miguel-antoons/feb_timing_gates/documentation/INDEX.md

# FEB Timing Gates Documentation Index

Welcome to the FEB Timing Gates documentation. This system provides precise timing for racing events using ESP32-based wireless timing gates.

## Getting Started
- [Project Overview](PROJECT_OVERVIEW.md) - System architecture and components
- [Hardware Setup](HARDWARE_SETUP.md) - Physical setup of timing gates
- [Software Setup](SOFTWARE_SETUP.md) - Installation and configuration

## Usage
- [Usage Guide](USAGE_GUIDE.md) - How to operate the system
- [Communication Protocol](COMMUNICATION_PROTOCOL.md) - Technical details about device communication
- [Device Management](DEVICE_MANAGEMENT.md) - Managing senders and receivers

## Reference
- [Troubleshooting](TROUBLESHOOTING.md) - Common issues and solutions

## Additional Resources
- [README](../../README.md) - Project overview and quick start guide
