miguel-antoons/feb_timing_gates/documentation/project_schema.pdf

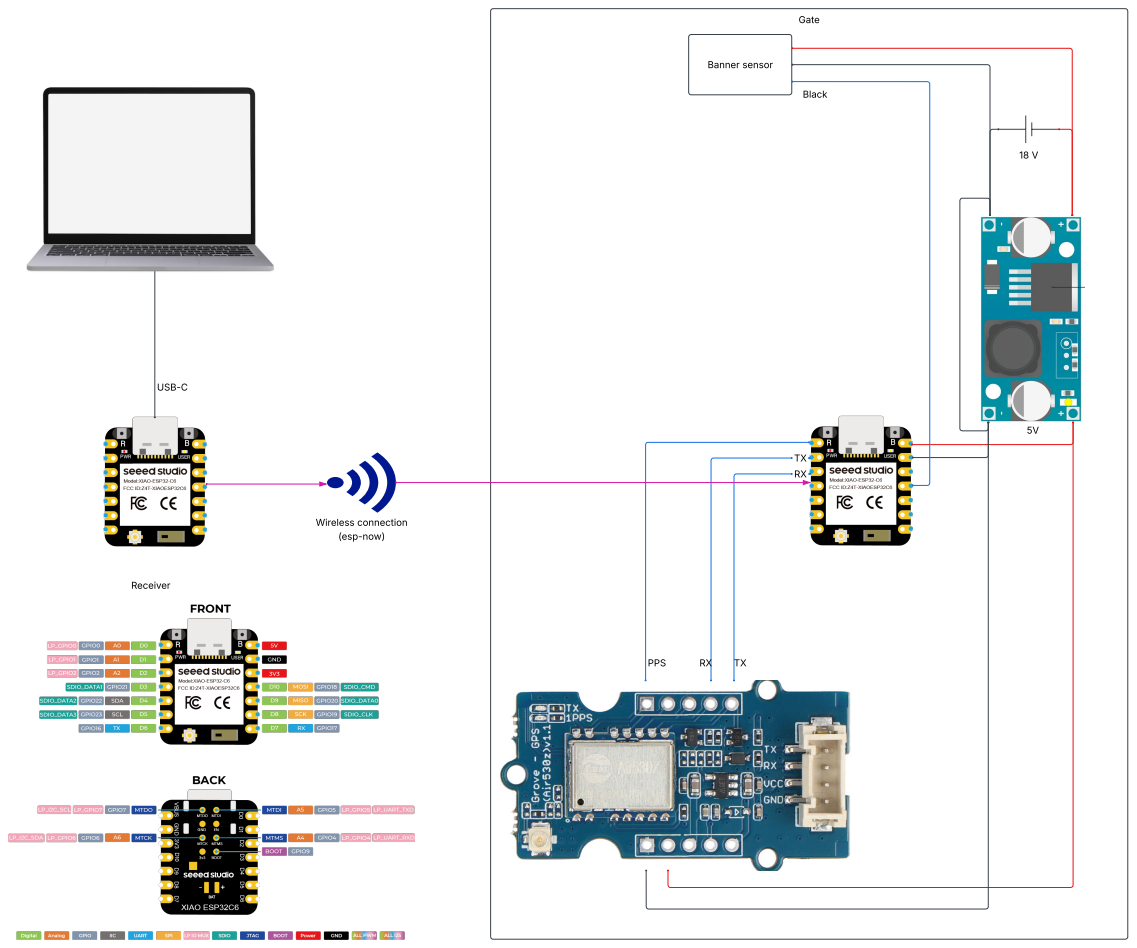
[picture p1: page 1]
PPS; Banner sensor; Gate; USB-C; Receiver; Wireless connection (esp-now); Black
