miguel-antoons/feb_timing_gates/(commit log)

2026-07-20 chore: adding program to simulate timing gates on esp32
2026-07-20 chore: adding tools programs for esp32 and reorganizing esp32 files
2026-08-18 chore: decreasing rest period after detection to make the sensor more reactive
2026-08-30 feat(esp32): turning on led during esp initialization
2026-08-30 feat: implementing the identify sender request, that pings a sender and lets it blink its led for some time
2026-08-30 chore(frontend): aligning connect buttons with pane headers
2026-09-22 refactor: renaming esp32 led pin
2026-09-22 feat(esp32): adding extra status led amber color
2026-09-22 feat(esp32): adding extra led and laser so that alignment is easier
2026-09-22 feat(esp32): making the gps lock non blocking so that the user can already align the timing gates while its locking
2026-09-30 fix(esp32): resolving an issue that caused the alignment led to turn on and off with a small delay
    [sender.ino]
